Sierra-Lobo/Sierra-Lobo-KiCad-libs/3dmodels/T1M-05-GF-DH.step

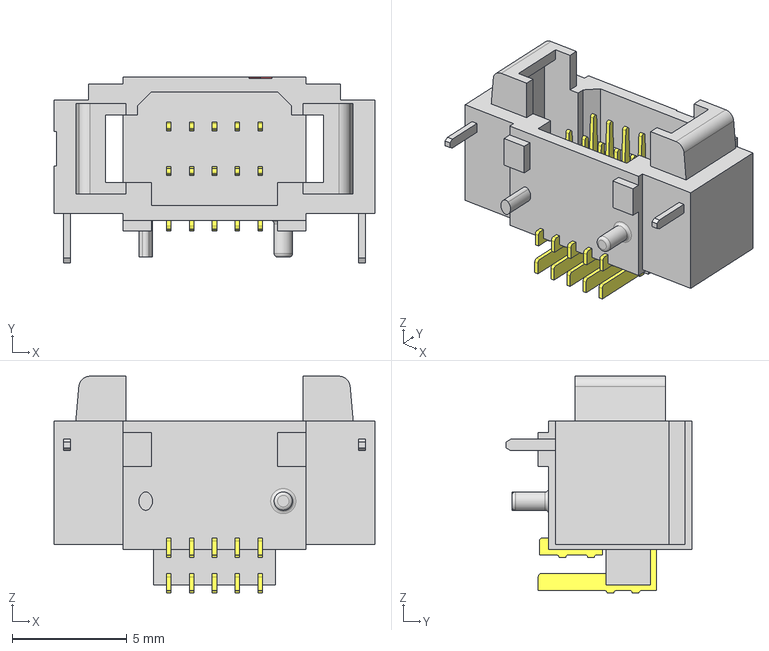
[picture p1: CAD file, 2023-08-02]
3dmodels/T1M-05-GF-DH.step
14.0 x 8.10 x 9.45 mm
P2T1M-05-T-DH
T1T1M-05-T-DH
