Sierra-Lobo/Sierra-Lobo-KiCad-libs/3dmodels/T1M-02-F-SH-L-K.step

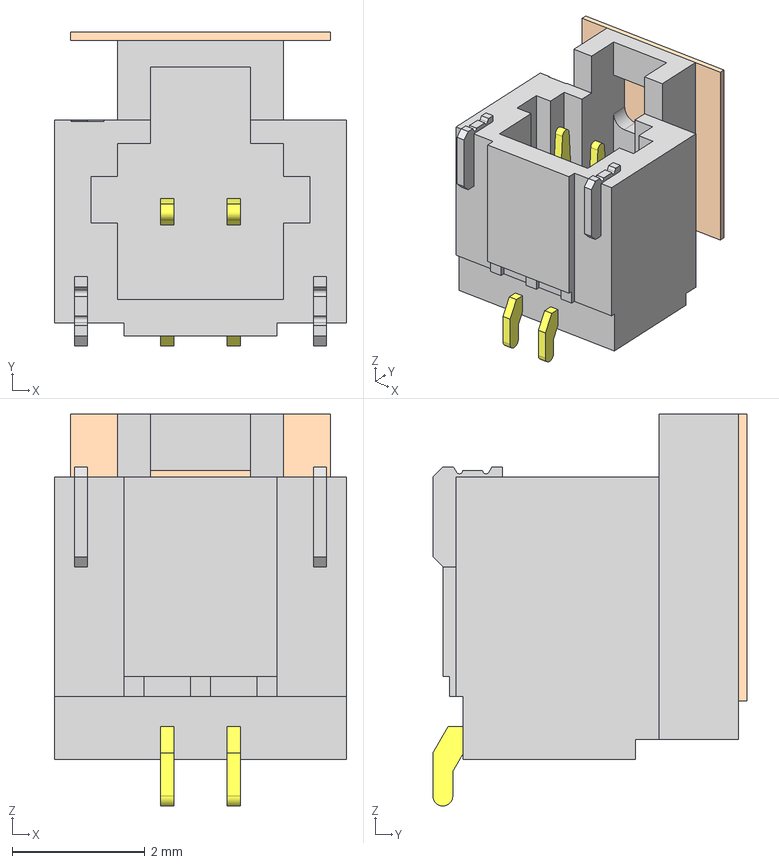
[picture p2: CAD file, 2023-07-25]
3dmodels/T1M-02-F-SH-L-K.step
4.40 x 4.73 x 5.90 mm
K-DOT-154x170-297-005
P2T1M-02-T-SH-L
T1T1M-02-T-SH-L
