Sierra-Lobo/Sierra-Lobo-KiCad-libs/3dmodels/IHLP-2020BZ-01.step

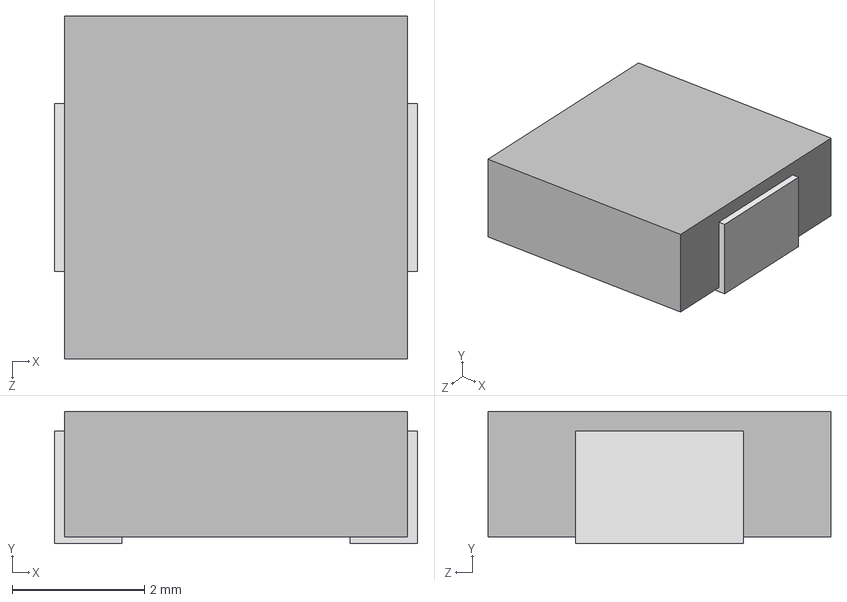
[picture p3: CAD file, 2023-07-25]
3dmodels/IHLP-2020BZ-01.step
5.49 x 2.00 x 5.18 mm
