Sierra-Lobo/Sierra-Lobo-KiCad-libs/3dmodels/T1M-02-F-SH-L.stp

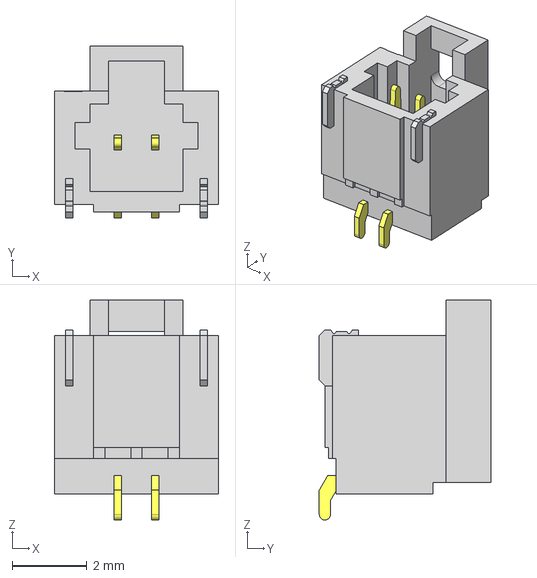
[picture p4: CAD file, 2023-07-25]
3dmodels/T1M-02-F-SH-L.stp
4.40 x 4.60 x 5.90 mm
P2T1M-02-T-SH-L
T1T1M-02-T-SH-L
