Sierra-Lobo/Sierra-Lobo-KiCad-libs/3dmodels/T1M-03-F-SH-L.step

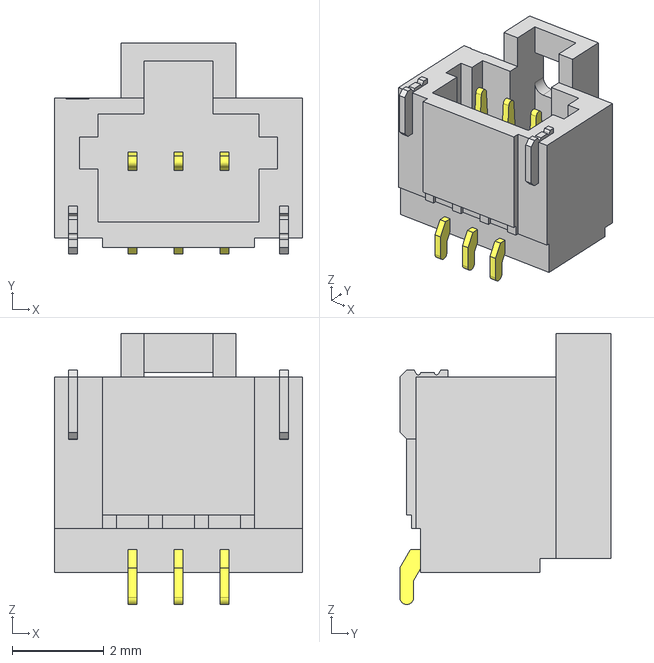
[picture p5: CAD file, 2023-07-25]
3dmodels/T1M-03-F-SH-L.step
5.40 x 4.60 x 5.90 mm
P2T1M-03-T-SH-L
T1T1M-03-T-SH-L
