Sierra-Lobo/Sierra-Lobo-KiCad-libs/3dmodels/T1M-03-F-SV-L.step

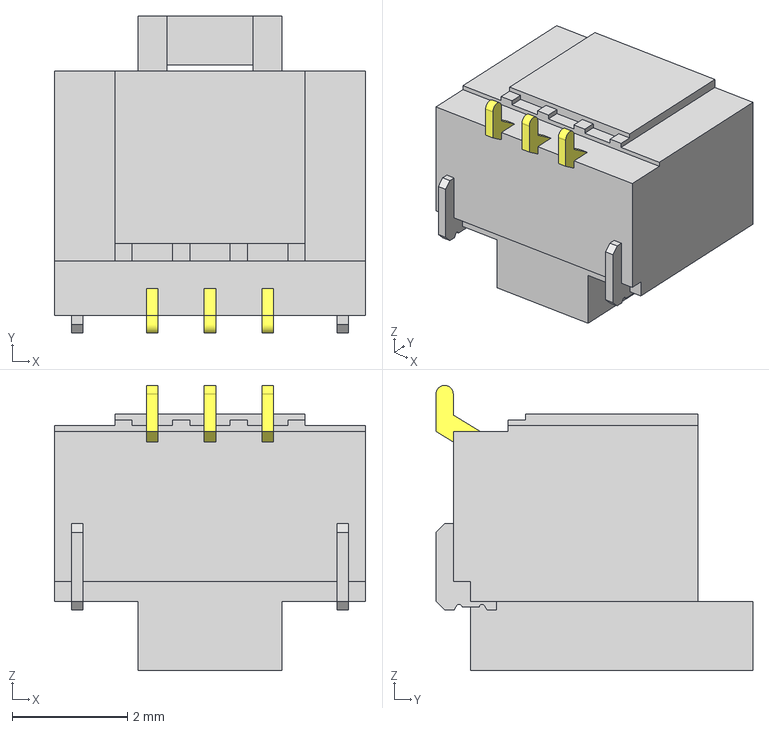
[picture p6: CAD file, 2023-07-25]
3dmodels/T1M-03-F-SV-L.step
5.40 x 5.50 x 4.95 mm
P2T1M-03-T-SV-L
T1T1M-03-T-SV-L
