Sierra-Lobo/Sierra-Lobo-KiCad-libs/3dmodels/imu-stamp_revA.step

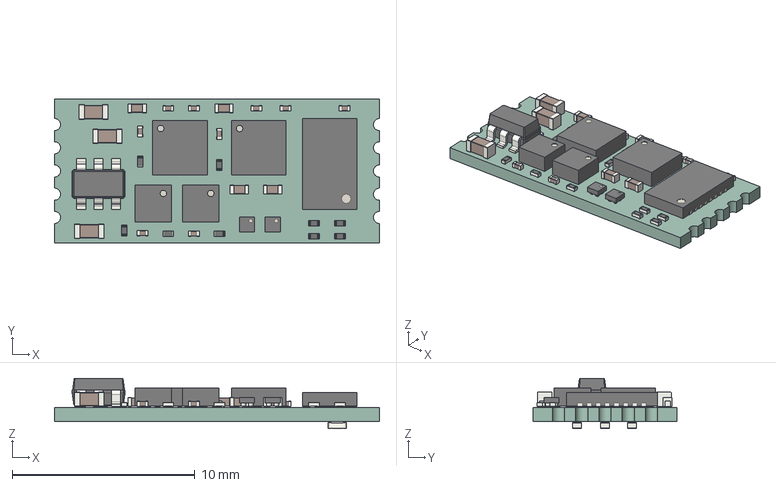
[picture p7: CAD file, 2023-06-14]
3dmodels/imu-stamp_revA.step
17.8 x 7.87 x 2.76 mm
PCB
