Sierra-Lobo/Sierra-Lobo-KiCad-libs/3dmodels/T1M-02-F-SV-L-P.step

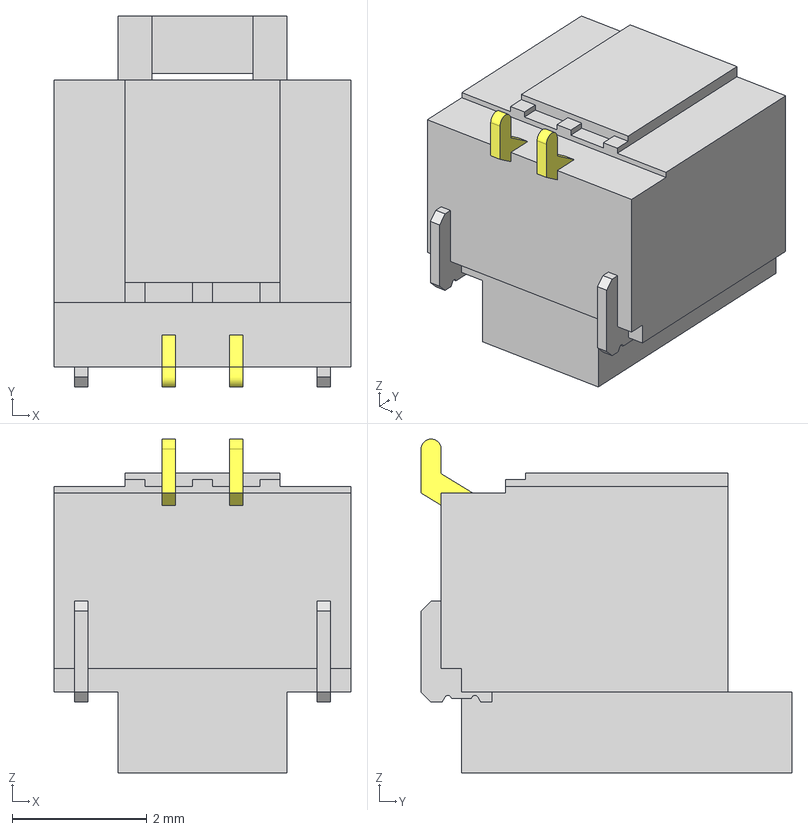
[picture p8: CAD file, 2023-05-31]
3dmodels/T1M-02-F-SV-L-P.step
4.40 x 5.50 x 4.95 mm
P2T1M-02-T-SV-L
T1T1M-02-T-SV-L
