Sierra-Lobo/Sierra-Lobo-KiCad-libs/3dmodels/SSM-102-L-SV-BE-TR.step

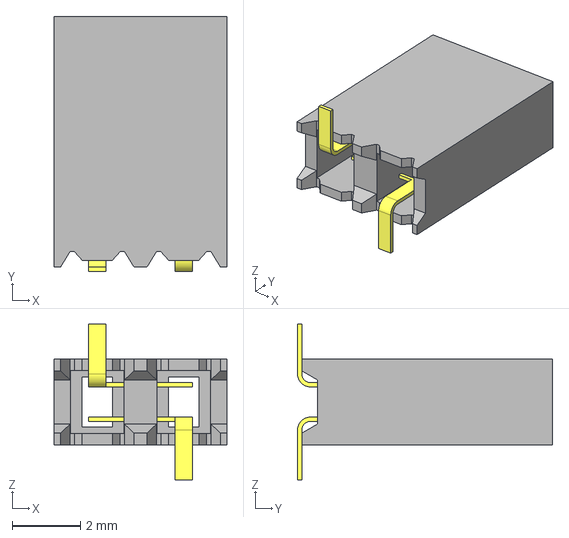
[picture p9: CAD file, 2023-05-31]
3dmodels/SSM-102-L-SV-BE-TR.step
5.08 x 7.49 x 4.57 mm
C-95-022
SSM-102-L-SV-BE-TR_body
