Sierra-Lobo/Sierra-Lobo-KiCad-libs/3dmodels/keystone-PN1056TR.STEP

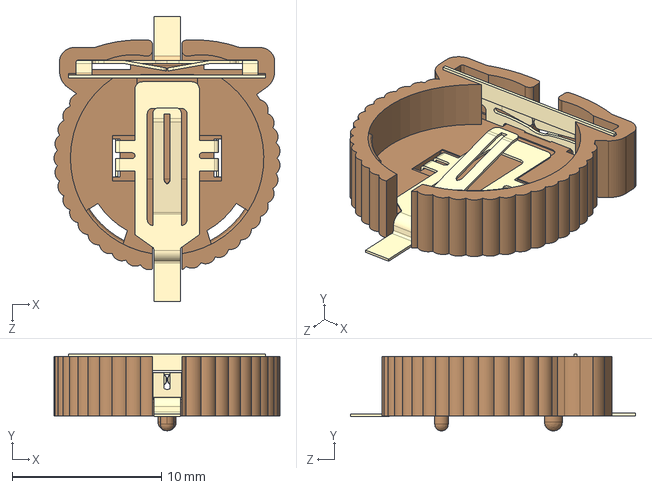
[picture p10: CAD file, 2023-05-31]
3dmodels/keystone-PN1056TR.STEP
15.1 x 5.16 x 19.1 mm
