Sierra-Lobo/Sierra-Lobo-KiCad-libs/3dmodels/KMR231NGLFS.STEP

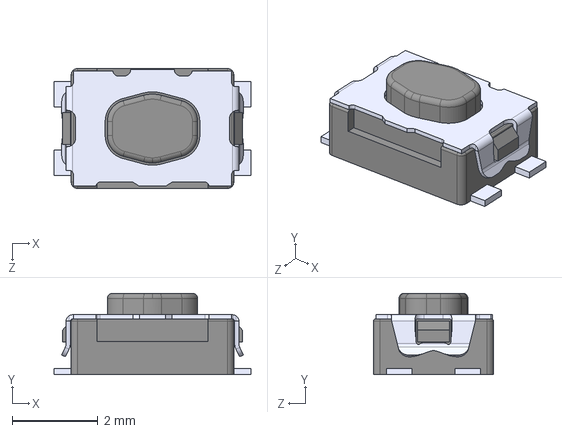
[picture p11: CAD file, 2023-05-19]
3dmodels/KMR231NGLFS.STEP
4.60 x 1.90 x 2.80 mm
