Sierra-Lobo/Sierra-Lobo-KiCad-libs/3dmodels/ZX62-AB-5PA.stp

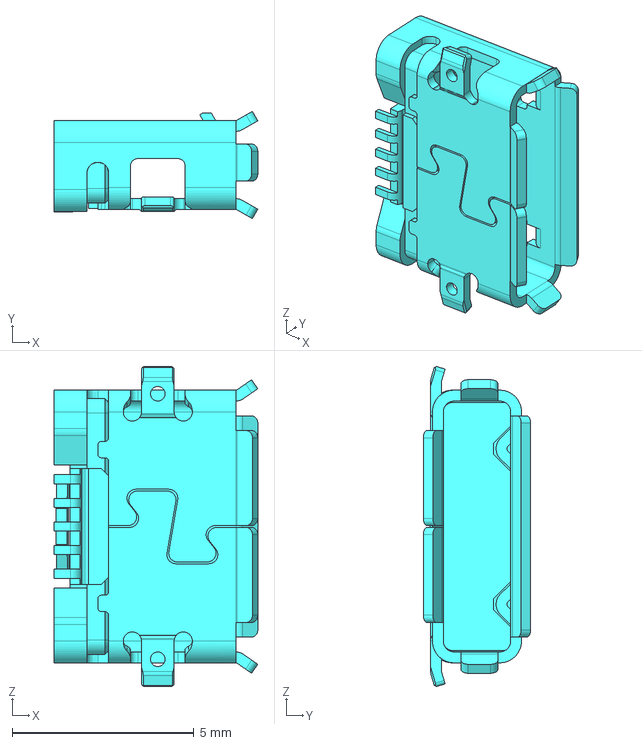
[picture p12: CAD file, 2023-05-19]
3dmodels/ZX62-AB-5PA.stp
5.60 x 2.95 x 8.80 mm
