Sierra-Lobo/Sierra-Lobo-KiCad-libs/3dmodels/INA230AIRGTR.STEP

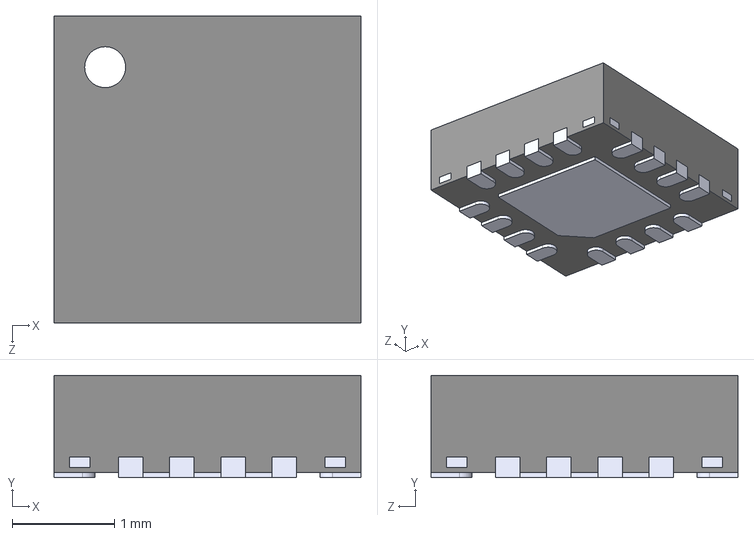
[picture p13: CAD file, 2023-05-19]
3dmodels/INA230AIRGTR.STEP
3.00 x 1.00 x 3.00 mm
