Sierra-Lobo/Sierra-Lobo-KiCad-libs/3dmodels/EVQP7-LC-01P-1.step

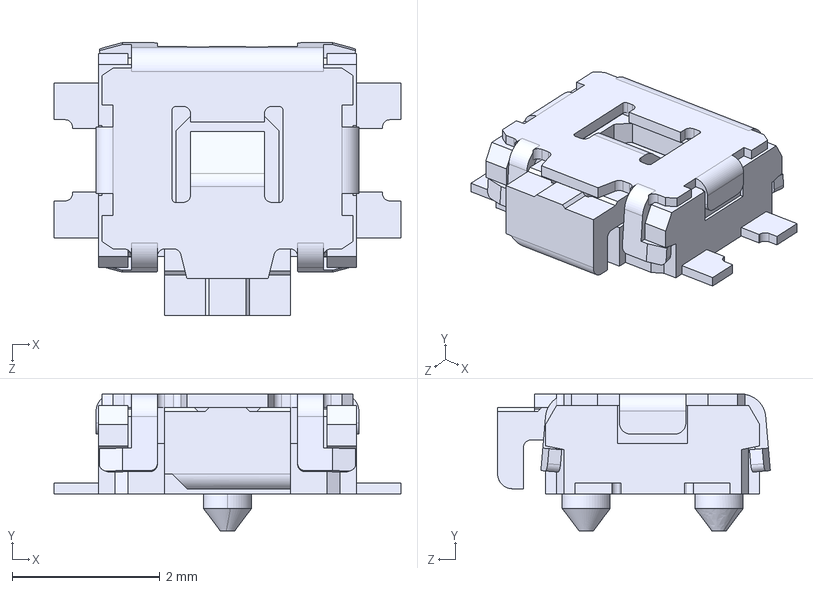
[picture p14: CAD file, 2023-05-19]
3dmodels/EVQP7-LC-01P-1.step
4.70 x 1.85 x 3.69 mm
