Sierra-Lobo/Sierra-Lobo-KiCad-libs/3dmodels/keystone-PN2998TR.STEP

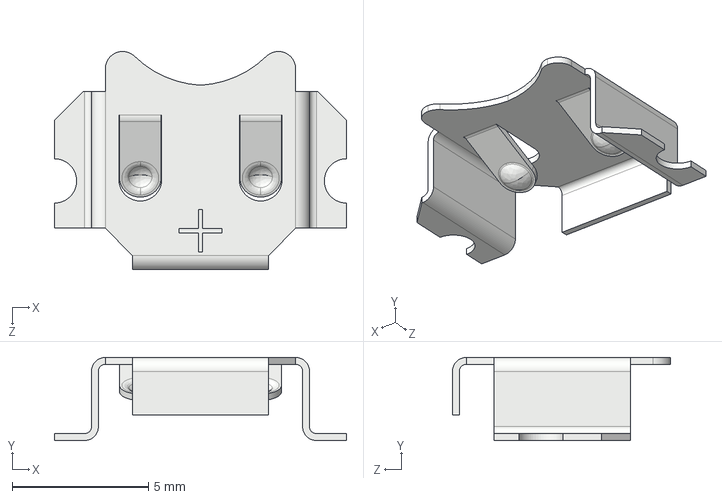
[picture p15: CAD file, 2023-05-19]
3dmodels/keystone-PN2998TR.STEP
10.7 x 3.05 x 8.00 mm
