Sierra-Lobo/Sierra-Lobo-KiCad-libs/3dmodels/sk68xx-ec3210F.stp

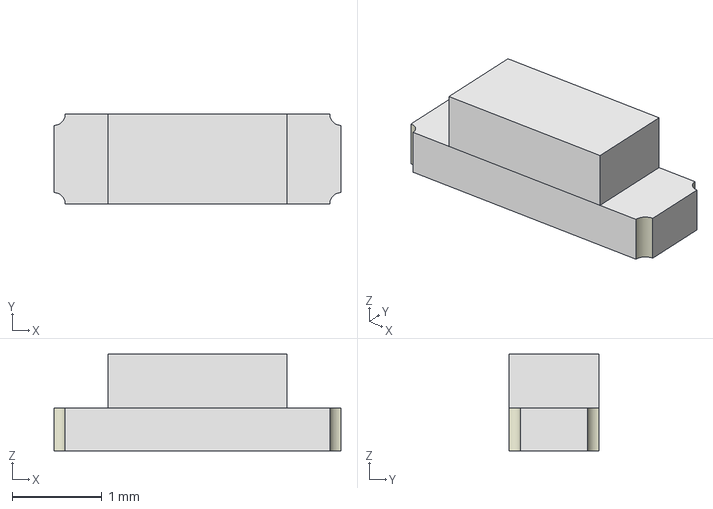
[picture p16: CAD file, 2023-05-19]
3dmodels/sk68xx-ec3210F.stp
3.20 x 1.00 x 1.08 mm
