Sierra-Lobo/Sierra-Lobo-KiCad-libs/3dmodels/SMPM-PS-P-HG-ST-TH-1.step

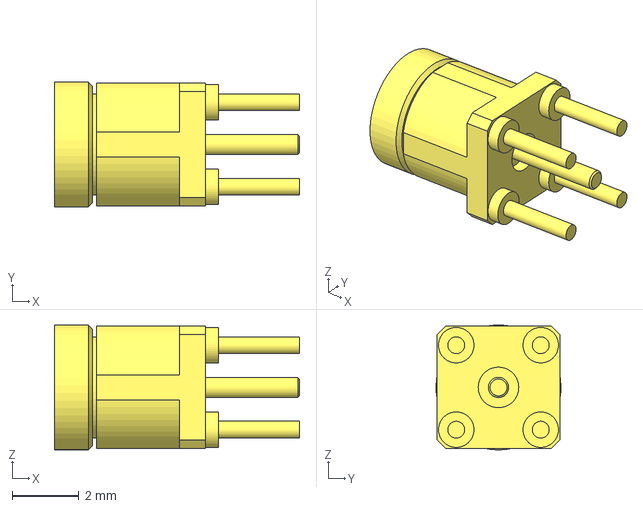
[picture p17: CAD file, 2023-05-19]
3dmodels/SMPM-PS-P-HG-ST-TH-1.step
7.37 x 3.76 x 3.76 mm
