Sierra-Lobo/Sierra-Lobo-KiCad-libs/3dmodels/ABS07-32.768KHZ-T.STEP

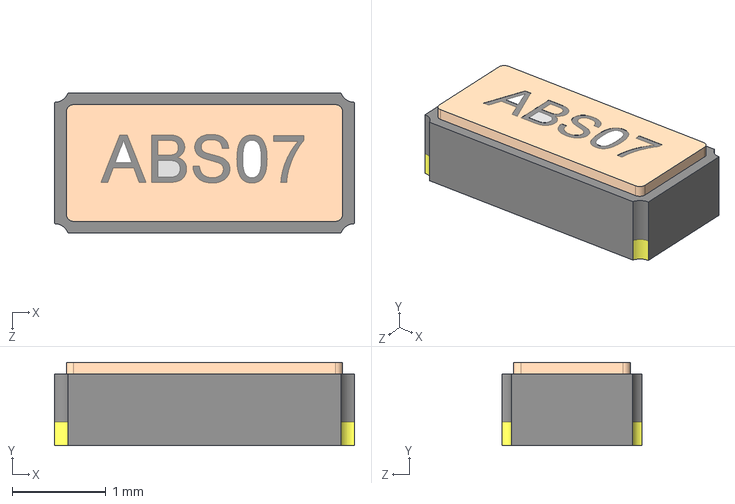
[picture p18: CAD file, 2023-05-19]
3dmodels/ABS07-32.768KHZ-T.STEP
3.20 x 0.889 x 1.50 mm
