Sierra-Lobo/Sierra-Lobo-KiCad-libs/3dmodels/KRL3216T4A.STEP

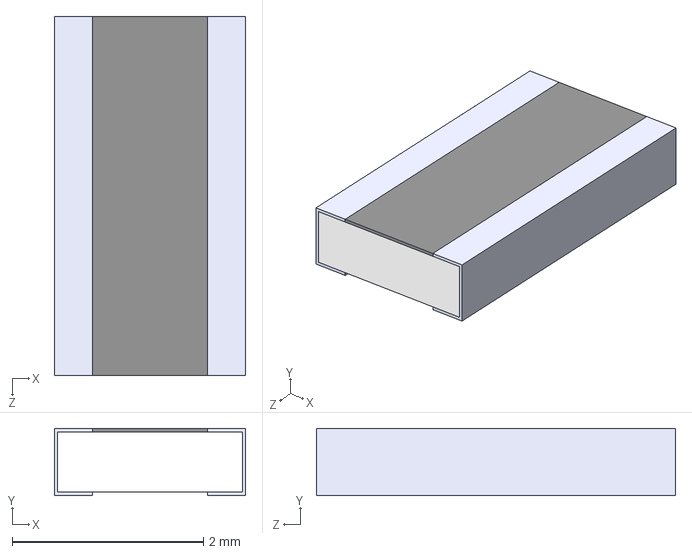
[picture p19: CAD file, 2023-05-19]
3dmodels/KRL3216T4A.STEP
2.00 x 0.7 x 3.75 mm
