Sierra-Lobo/Sierra-Lobo-KiCad-libs/3dmodels/D_SMP.step

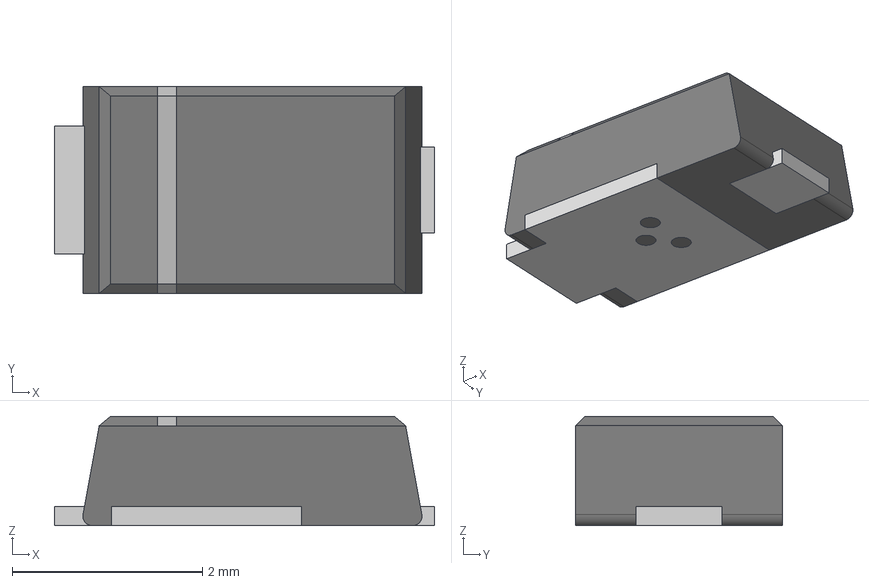
[picture p20: CAD file, 2023-05-19]
3dmodels/D_SMP.step
4.00 x 2.18 x 1.15 mm
Cathode Band
Pads
