Sierra-Lobo/Sierra-Lobo-KiCad-libs/3dmodels/WE-HCI-5040_rev1.stp

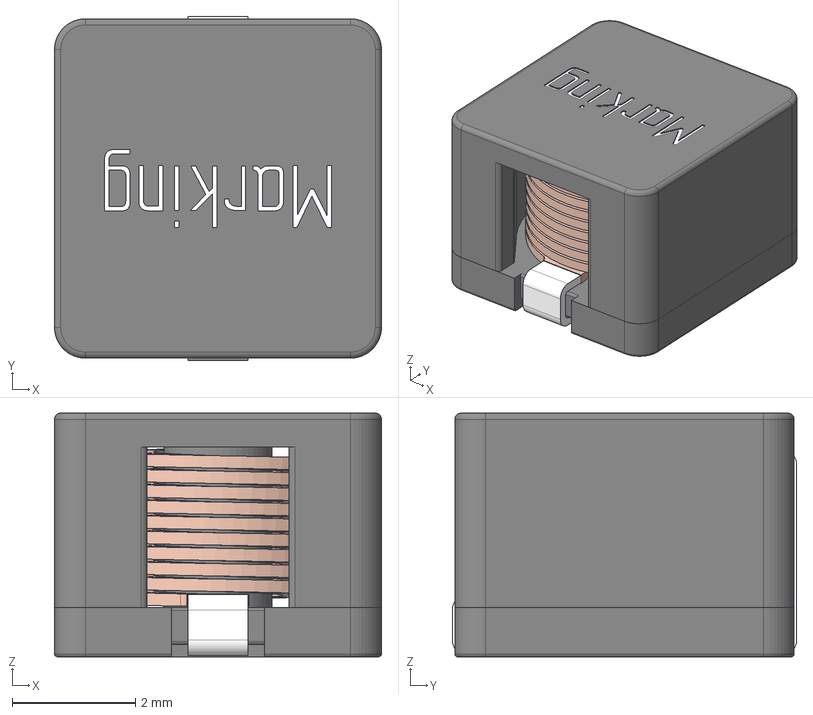
[picture p21: CAD file, 2023-05-19]
3dmodels/WE-HCI-5040_rev1.stp
5.30 x 5.58 x 3.95 mm
Gehäuse
Boden
Spule
