Sierra-Lobo/Sierra-Lobo-KiCad-libs/3dmodels/SOT-723.STEP

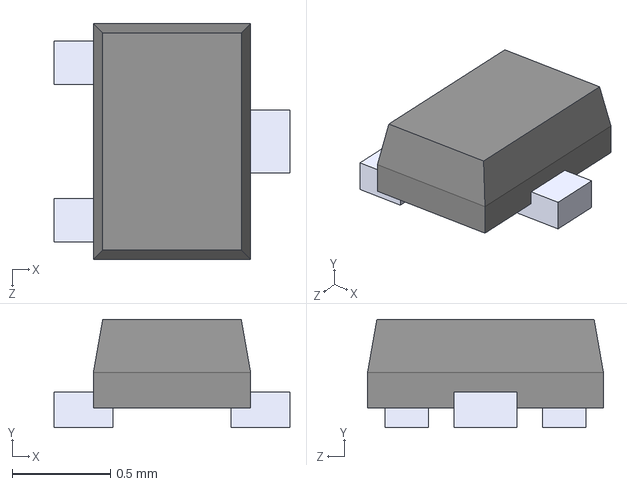
[picture p22: CAD file, 2023-05-19]
3dmodels/SOT-723.STEP
1.20 x 0.55 x 1.20 mm
