Sierra-Lobo/Sierra-Lobo-KiCad-libs/3dmodels/RFM98W.STEP

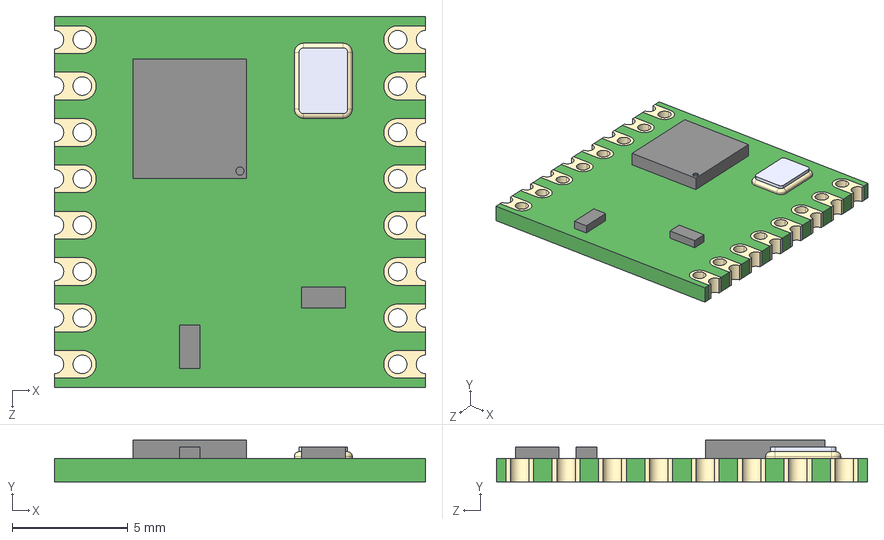
[picture p23: CAD file, 2023-05-19]
3dmodels/RFM98W.STEP
16.0 x 1.80 x 16.0 mm
