Sierra-Lobo/Sierra-Lobo-KiCad-libs/3dmodels/ESD321DPYR.STEP

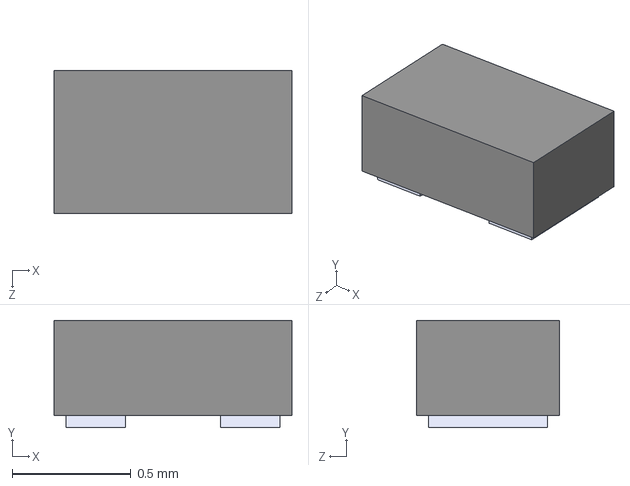
[picture p24: CAD file, 2023-05-19]
3dmodels/ESD321DPYR.STEP
1.00 x 0.45 x 0.6 mm
