Sierra-Lobo/Sierra-Lobo-KiCad-libs/3dmodels/APA2107.STEP

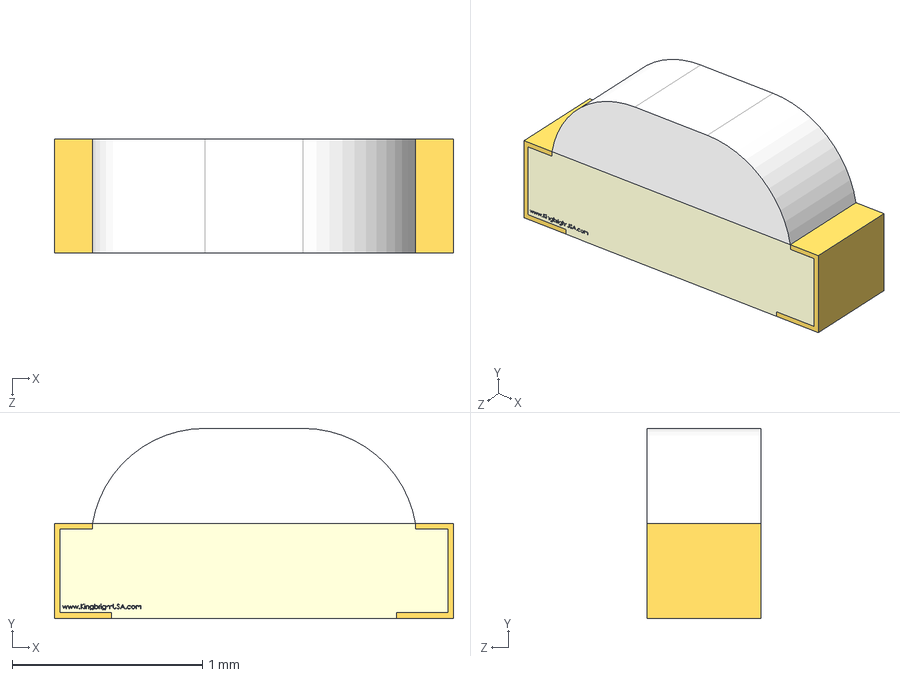
[picture p25: CAD file, 2023-05-19]
3dmodels/APA2107.STEP
2.10 x 1.00 x 0.6 mm
