Sierra-Lobo/Sierra-Lobo-KiCad-libs/3dmodels/MINI-QFN-16L.stp

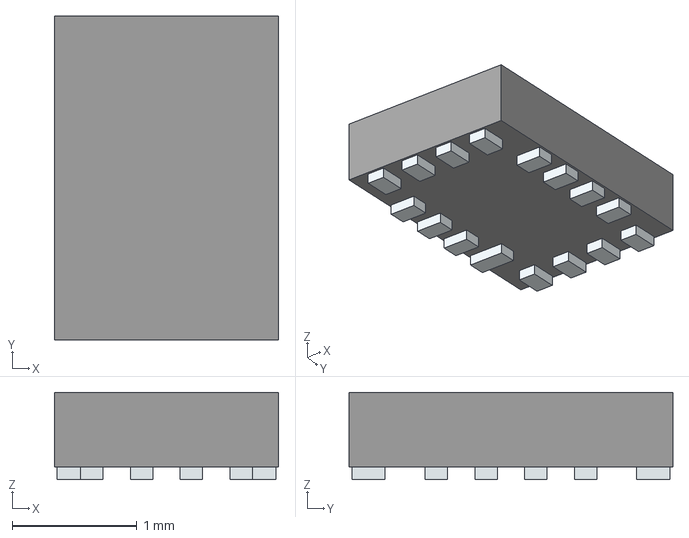
[picture p26: CAD file, 2023-05-19]
3dmodels/MINI-QFN-16L.stp
1.80 x 2.60 x 0.7 mm
Pins
