Sierra-Lobo/Sierra-Lobo-KiCad-libs/3dmodels/WE-LQS-3015_rev1.stp

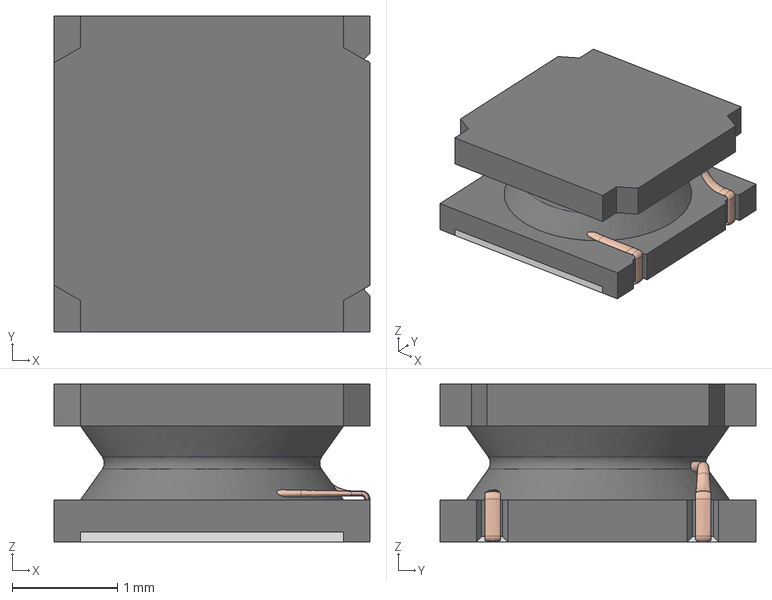
[picture p27: CAD file, 2023-05-19]
3dmodels/WE-LQS-3015_rev1.stp
3.00 x 3.00 x 1.50 mm
