Sierra-Lobo/Sierra-Lobo-KiCad-libs/3dmodels/SFM-130-01-L-D-DS.step

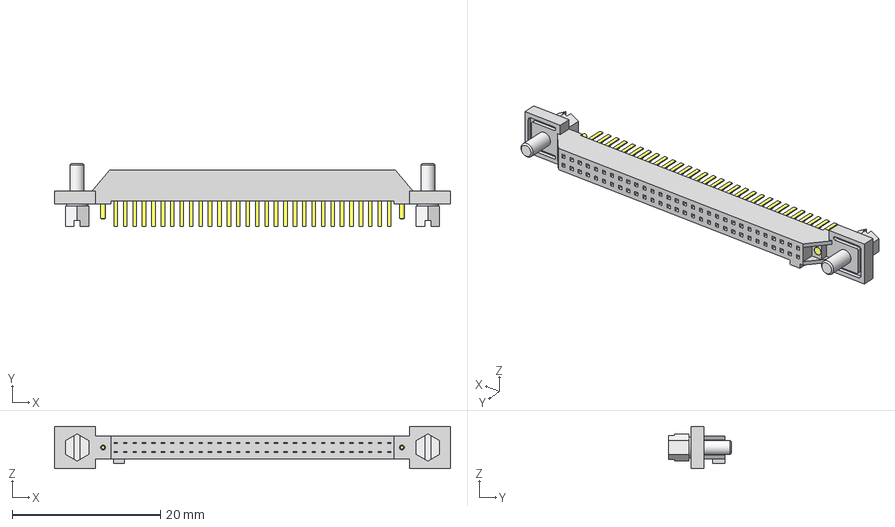
[picture p28: CAD file, 2023-05-12]
3dmodels/SFM-130-01-L-D-DS.step
53.3 x 8.51 x 5.71 mm
WT-27-03-T_-01-D-DS-SN_solder_nail x 2
C-30-01-D_pins
CPS-RR-M2-01_dual_screw x 2
SFM-130-01-L-D-DS_terminal
