Sierra-Lobo/Sierra-Lobo-KiCad-libs/3dmodels/UMPS-04-05.5-G-V-S-TR.stp

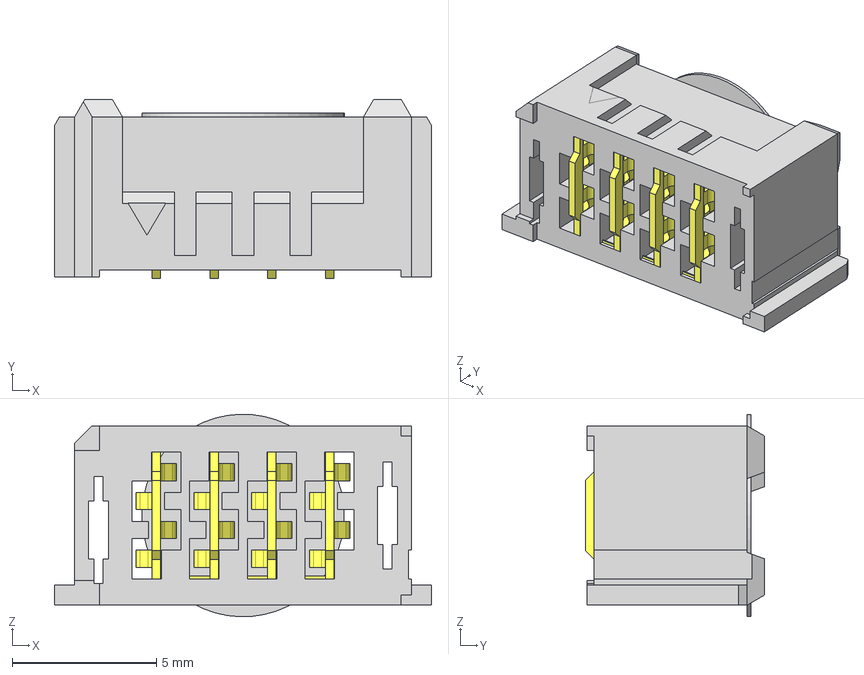
[picture p29: CAD file, 2023-05-12]
3dmodels/UMPS-04-05.5-G-V-S-TR.stp
13.1 x 6.20 x 7.01 mm
K-DOT-0.276-.005_KAPTON
04-05.5-S_PINS2
UMPS-04-05.5-S_PINS
04-05.5--_BODY
