Sierra-Lobo/Sierra-Lobo-KiCad-libs/3dmodels/CKG57NX7S1C107M500JJ.step

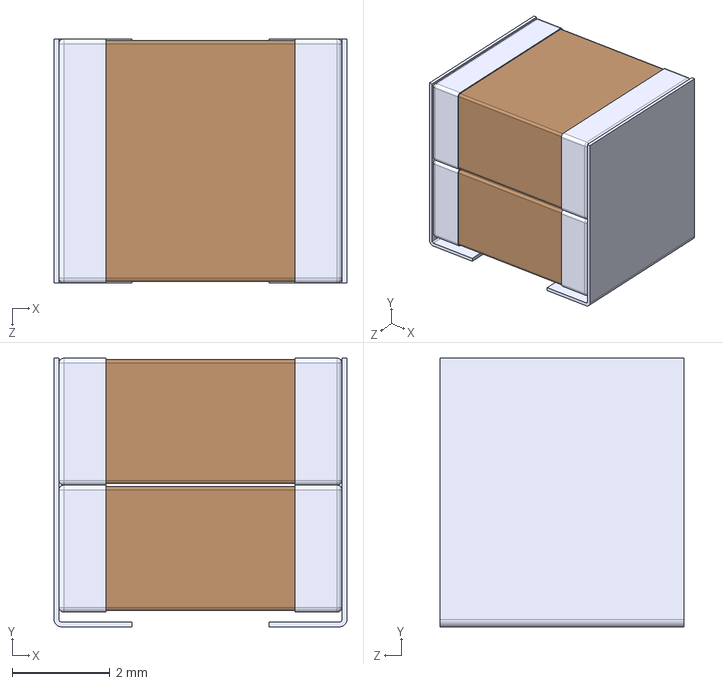
[picture p30: CAD file, 2023-05-07]
3dmodels/CKG57NX7S1C107M500JJ.step
6.00 x 5.50 x 5.00 mm
