Sierra-Lobo/Sierra-Lobo-KiCad-libs/3dmodels/RAVF164D.stp

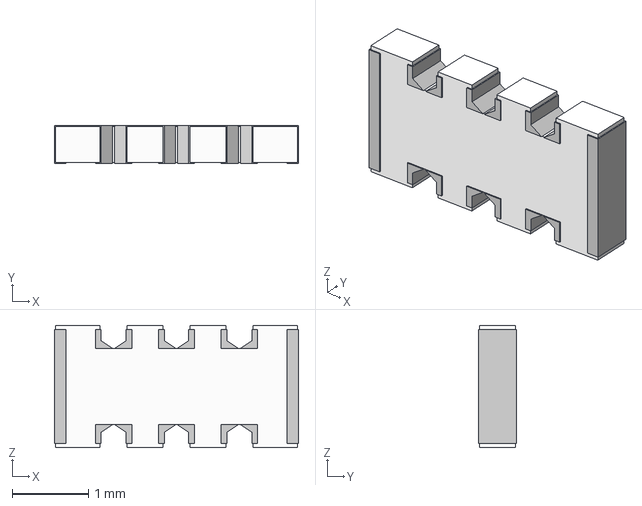
[picture p31: CAD file, 2023-04-01]
3dmodels/RAVF164D.stp
3.20 x 0.5 x 1.60 mm
