Sierra-Lobo/Sierra-Lobo-KiCad-libs/3dmodels/RockBLOCK_V_3B.STEP

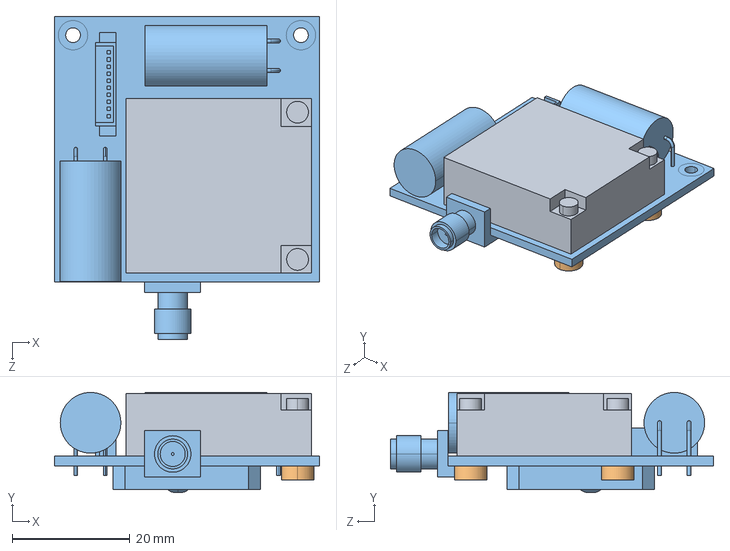
[picture p32: CAD file, 2023-04-01]
3dmodels/RockBLOCK_V_3B.STEP
45.0 x 17.0 x 54.9 mm
