Sierra-Lobo/Sierra-Lobo-KiCad-libs/3dmodels/WE-PD_1210.stp

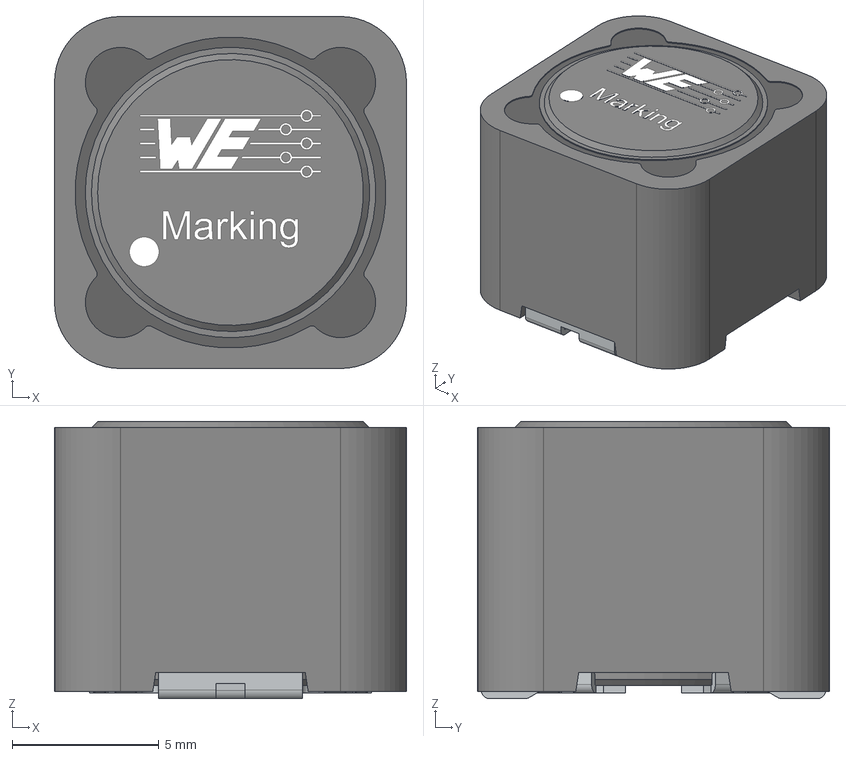
[picture p33: CAD file, 2023-04-01]
3dmodels/WE-PD_1210.stp
12.0 x 12.0 x 9.46 mm
Core
ShieldRing
Glue
Leadframe
