Sierra-Lobo/Sierra-Lobo-KiCad-libs/3dmodels/CLP-130-02-X-D-BE-A-P-TR.step

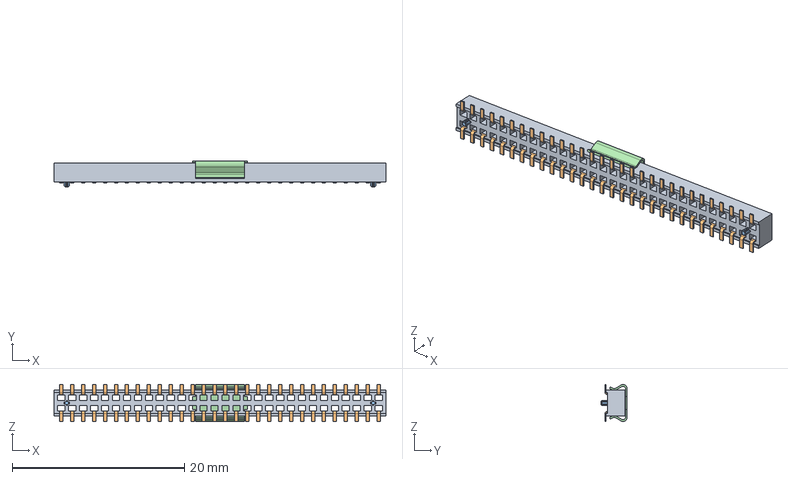
[picture p34: CAD file, 2023-04-01]
3dmodels/CLP-130-02-X-D-BE-A-P-TR.step
38.5 x 3.02 x 4.32 mm
_CLP-130-2-F-D-BE-A-P_terminal
_C-106-22-130-BE_Pin x 2
_CLP_ap x 2
_LMP-01-CLP30_mp
