Sierra-Lobo/Sierra-Lobo-KiCad-libs/3dmodels/T2M-105-01-X-D-TH-DS.step

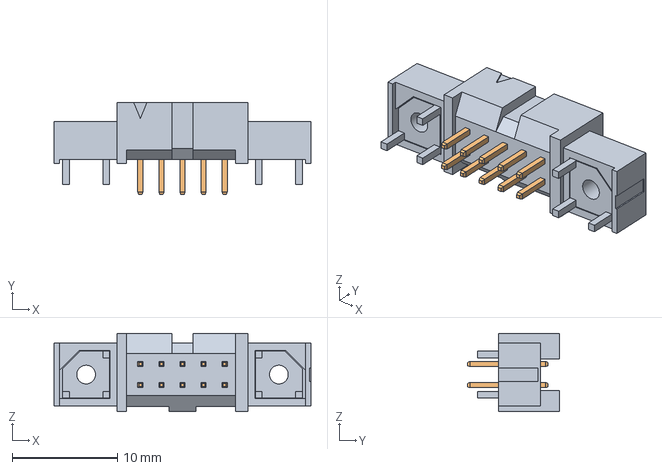
[picture p35: CAD file, 2023-04-01]
3dmodels/T2M-105-01-X-D-TH-DS.step
24.4 x 8.76 x 7.44 mm
_B1T2M-05-D-TH-DS
_P2T2M-05-D-TH-DS
