Sierra-Lobo/Sierra-Lobo-KiCad-libs/3dmodels/R107.064.070C.stp

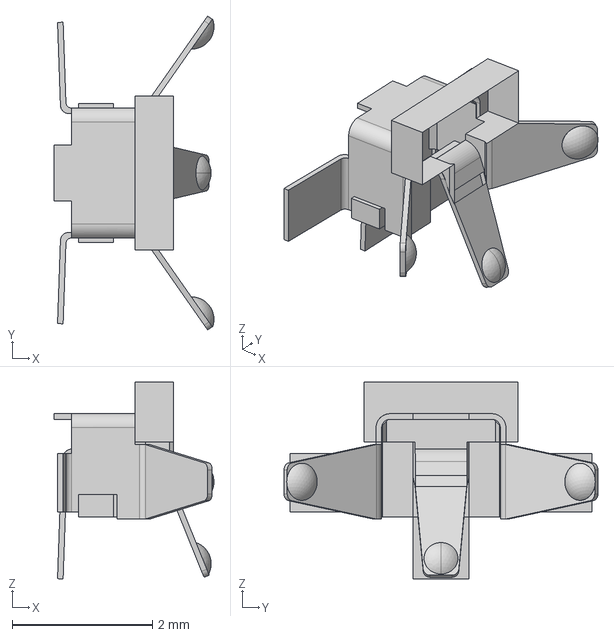
[picture p36: CAD file, 2023-04-01]
3dmodels/R107.064.070C.stp
2.28 x 4.47 x 2.80 mm
