Sierra-Lobo/Sierra-Lobo-KiCad-libs/3dmodels/T1M-06-F-SV-L.step

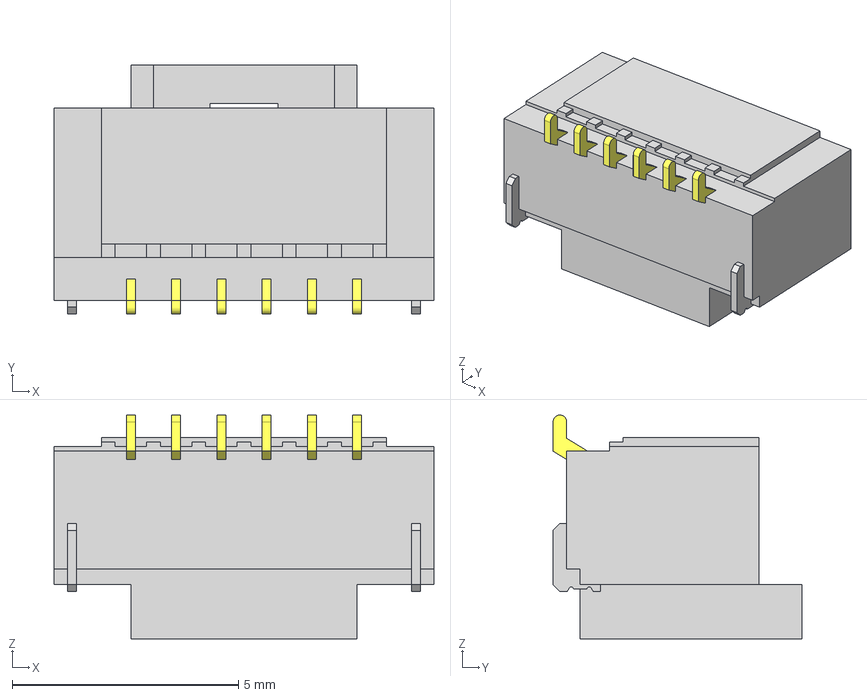
[picture p37: CAD file, 2023-04-01]
3dmodels/T1M-06-F-SV-L.step
8.40 x 5.50 x 4.95 mm
_T1T1M-06-T-SV-L
_P2T1M-06-T-SV-L
