Sierra-Lobo/Sierra-Lobo-KiCad-libs/3dmodels/SMPM-PS-P-HG-ST-EM-1.stp

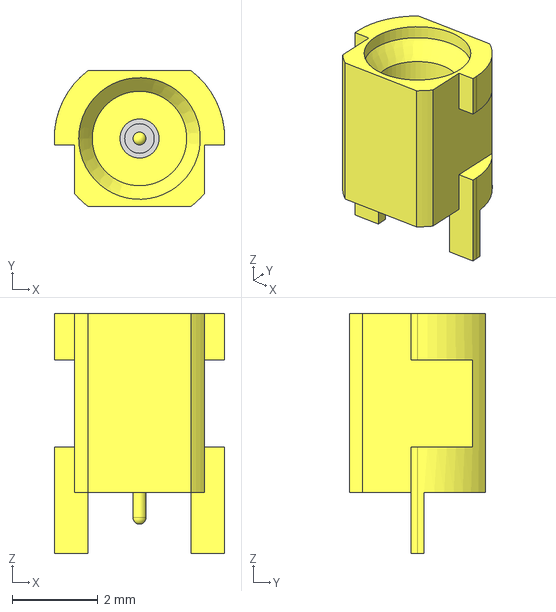
[picture p39: CAD file, 2023-04-01]
3dmodels/SMPM-PS-P-HG-ST-EM-1.stp
3.99 x 3.17 x 5.61 mm
