Sierra-Lobo/Sierra-Lobo-KiCad-libs/3dmodels/SSM-130-L-DV.step

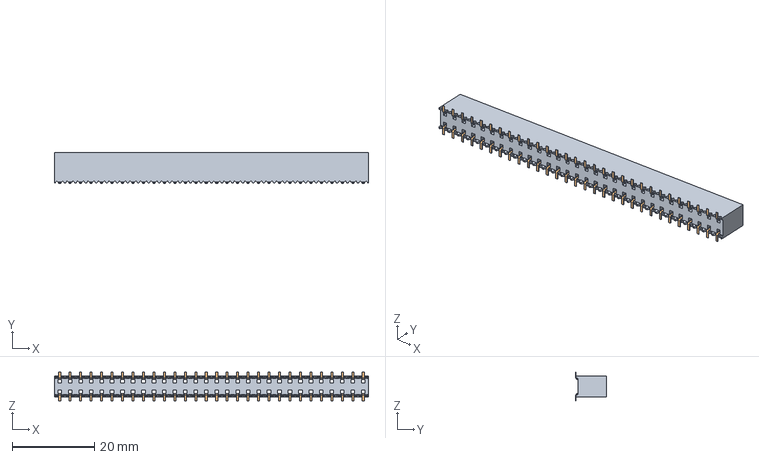
[picture p41: CAD file, 2023-04-01]
3dmodels/SSM-130-L-DV.step
76.2 x 7.42 x 7.04 mm
_SSM-130-L-DV_body
_C-137-0130
