Sierra-Lobo/Sierra-Lobo-KiCad-libs/3dmodels/SRN8040TA-6R8M.STEP

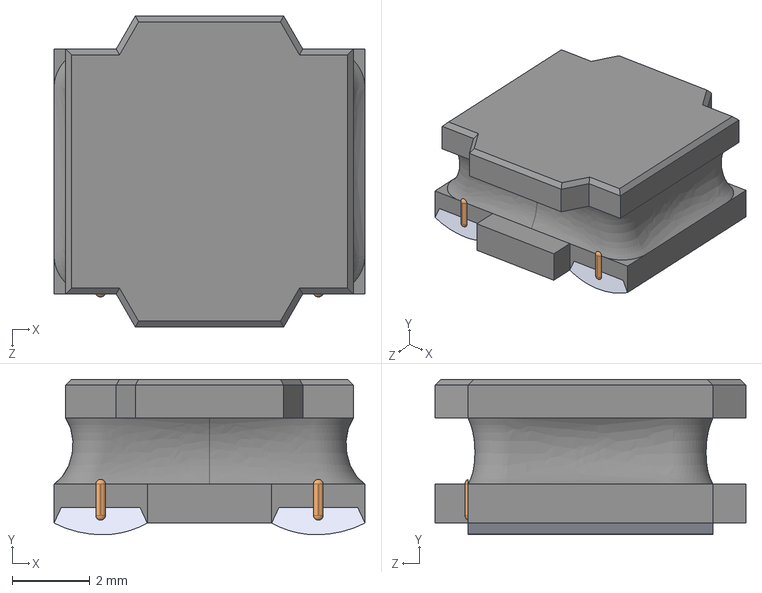
[picture p42: CAD file, 2023-04-01]
3dmodels/SRN8040TA-6R8M.STEP
8.00 x 4.00 x 8.00 mm
