Sierra-Lobo/Sierra-Lobo-KiCad-libs/3dmodels/T1M-15-X-DV.step

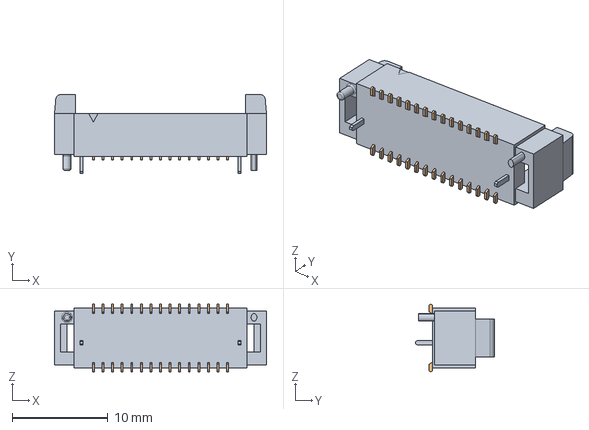
[picture p43: CAD file, 2023-04-01]
3dmodels/T1M-15-X-DV.step
22.1 x 8.20 x 7.05 mm
_T1T1M-15-T-DV
_P2T1M-15-T-DV
