Sierra-Lobo/Sierra-Lobo-KiCad-libs/3dmodels/DF13-4P-1.25DSA.stp

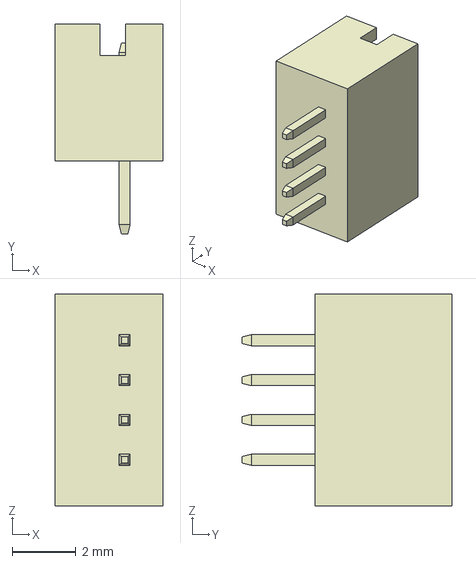
[picture p46: CAD file, 2023-04-01]
3dmodels/DF13-4P-1.25DSA.stp
3.40 x 6.60 x 6.65 mm
