Sierra-Lobo/Sierra-Lobo-KiCad-libs/3dmodels/ADM1176-1ARMZ-R7.STEP

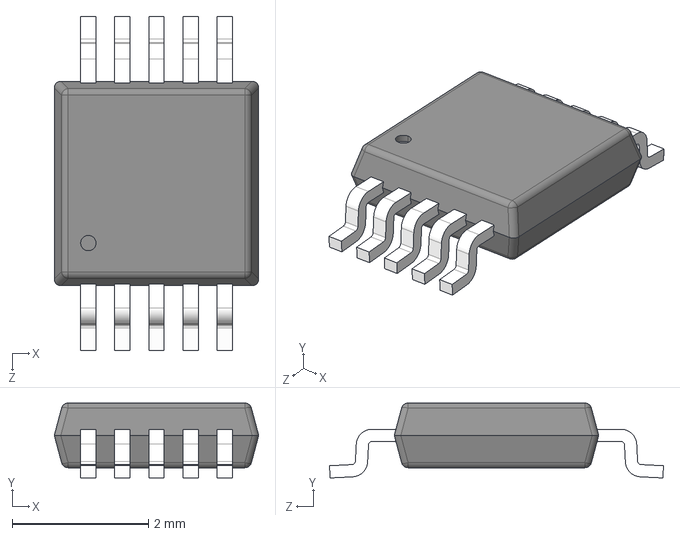
[picture p47: CAD file, 2023-04-01]
3dmodels/ADM1176-1ARMZ-R7.STEP
3.00 x 1.10 x 4.90 mm
