Sierra-Lobo/Sierra-Lobo-KiCad-libs/3dmodels/LED_Ring.step

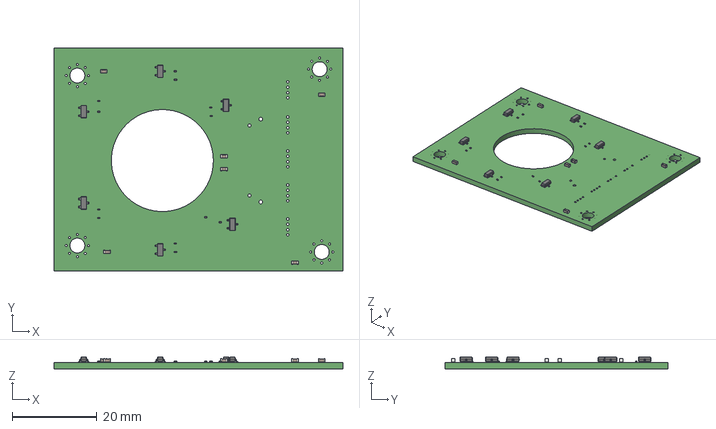
[picture p48: CAD file, 2023-04-01]
3dmodels/LED_Ring.step
68.0 x 52.5 x 2.85 mm
