Sierra-Lobo/Sierra-Lobo-KiCad-libs/3dmodels/FTSH-130-04-L-DH.step

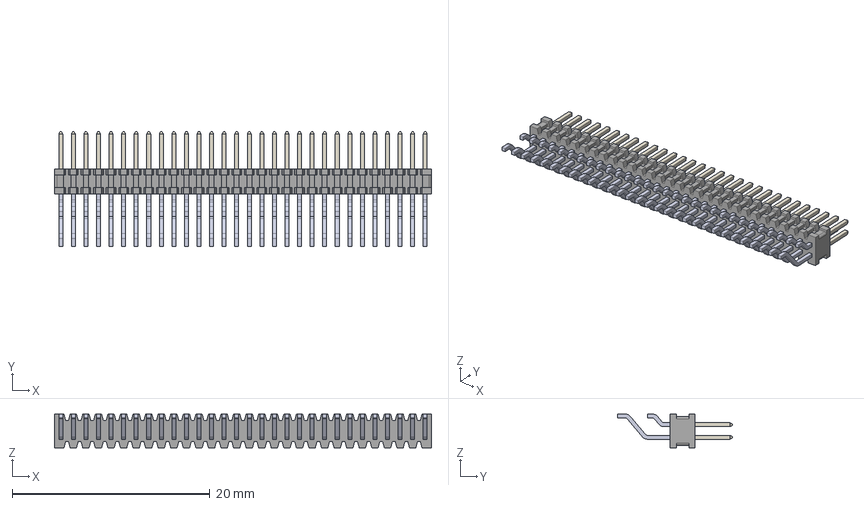
[picture p49: CAD file, 2023-04-01]
3dmodels/FTSH-130-04-L-DH.step
38.1 x 11.7 x 3.43 mm
