Sierra-Lobo/Sierra-Lobo-KiCad-libs/3dmodels/WE-PD_1260.stp

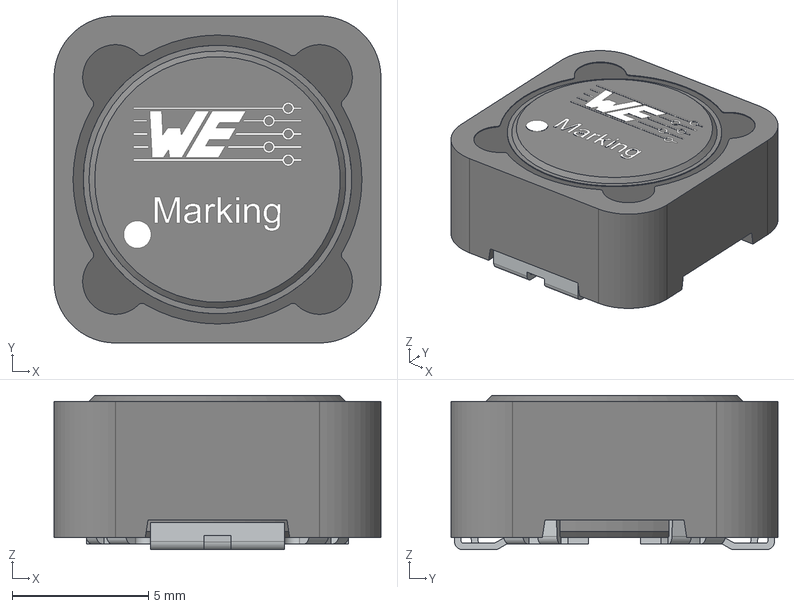
[picture p50: CAD file, 2023-04-01]
3dmodels/WE-PD_1260.stp
12.0 x 12.0 x 5.66 mm
Core
ShieldRing
Glue
Leadframe
