Sierra-Lobo/Sierra-Lobo-KiCad-libs/3dmodels/LM301H.stp

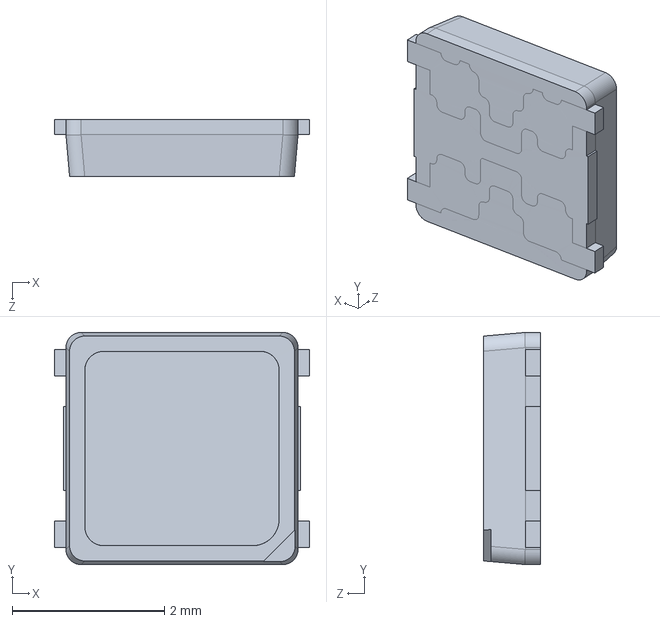
[picture p51: CAD file, 2023-04-01]
3dmodels/LM301H.stp
3.35 x 3.05 x 0.751 mm
