Sierra-Lobo/Sierra-Lobo-KiCad-libs/3dmodels/DF13-10P-1.25DSA.stp

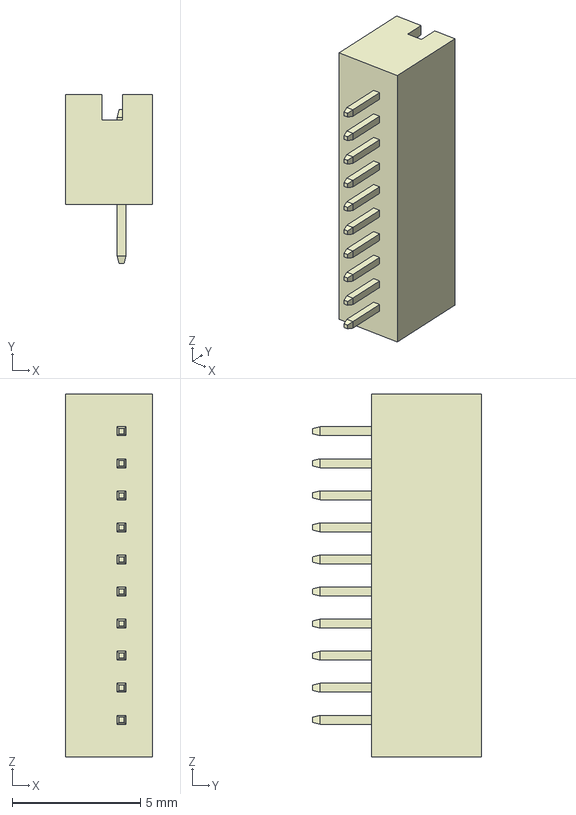
[picture p52: CAD file, 2023-04-01]
3dmodels/DF13-10P-1.25DSA.stp
3.40 x 6.60 x 14.1 mm
