Sierra-Lobo/Sierra-Lobo-KiCad-libs/3dmodels/6021-0-15-15-16-XX-10-0.step

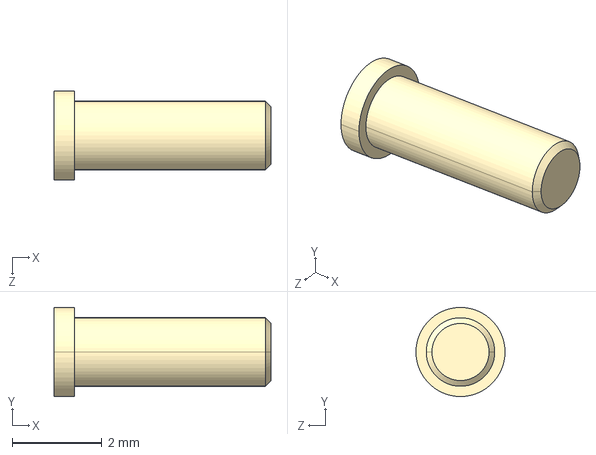
[picture p53: CAD file, 2023-04-01]
3dmodels/6021-0-15-15-16-XX-10-0.step
4.83 x 1.98 x 1.98 mm
