Sierra-Lobo/Sierra-Lobo-KiCad-libs/3dmodels/2-1437565-9.step

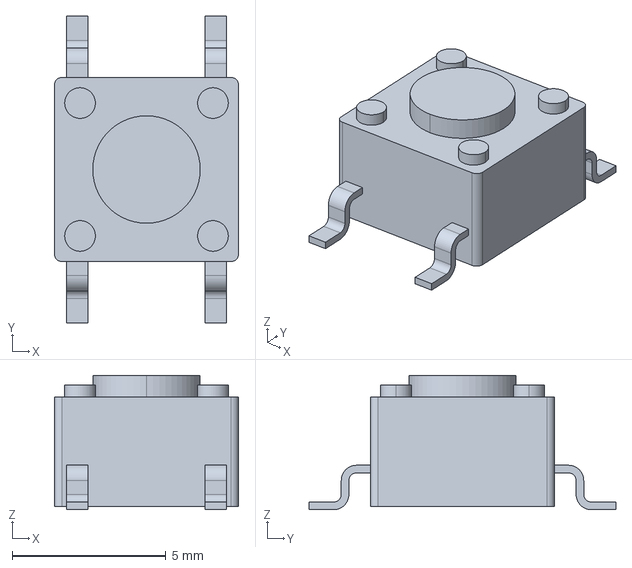
[picture p54: CAD file, 2023-04-01]
3dmodels/2-1437565-9.step
6.00 x 10.0 x 4.38 mm
