Sierra-Lobo/Sierra-Lobo-KiCad-libs/3dmodels/B3B-ZR.STEP

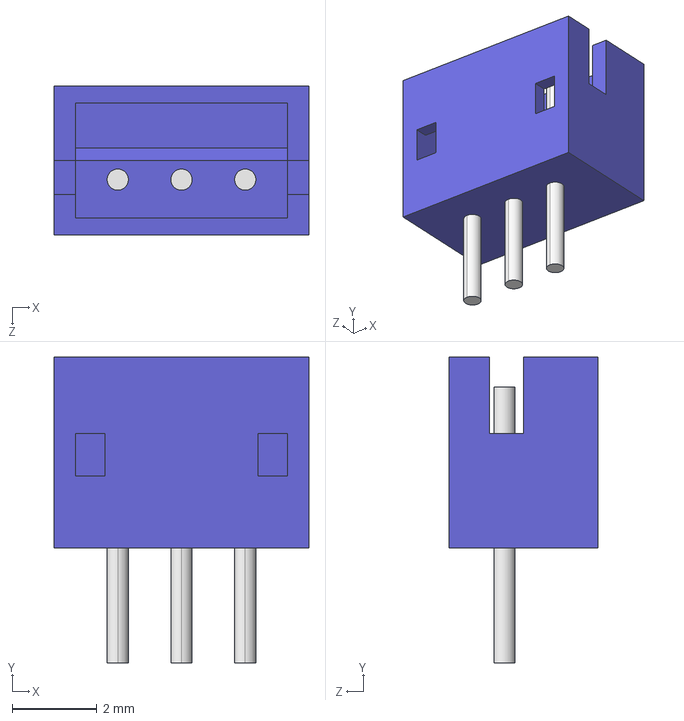
[picture p55: CAD file, 2023-04-01]
3dmodels/B3B-ZR.STEP
6.00 x 7.20 x 3.50 mm
