Sierra-Lobo/Sierra-Lobo-KiCad-libs/3dmodels/T1M-08-F-SV-L.step

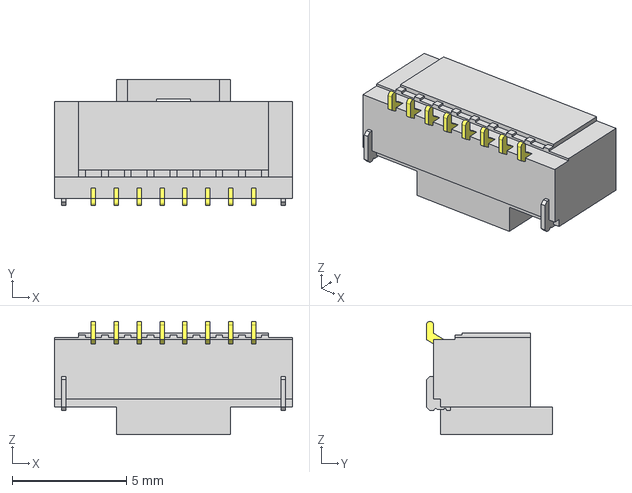
[picture p57: CAD file, 2023-03-30]
3dmodels/T1M-08-F-SV-L.step
10.4 x 5.50 x 4.95 mm
_T1T1M-08-T-SV-L
_P2T1M-08-T-SV-L
