Sierra-Lobo/Sierra-Lobo-KiCad-libs/(list of files, cad)

Other CAD files:
3dmodels/1625854-3.step
3dmodels/5031821852--3DModel-STEP-56544.STEP
3dmodels/733000030.stp
3dmodels/OS102011MS2QN1.step
3dmodels/PE014006.stp
3dmodels/RockBLOCK_V_3B.stp
3dmodels/T1M-03-F-SV-L.stp
3dmodels/T1M-04-F-SV-L.stp
3dmodels/TPS54226PWPR.STEP
3dmodels/TPS630701RNMR.STEP
