Sierra-Lobo/Sierra-Lobo-KiCad-libs/(commit log)

2023-04-01 moved most project footprints here.
    [2-1437565-9.step, 6021-0-15-15-16-XX-10-0.step, 733000030.stp, ADM1176-1ARMZ-R7.STEP, B3B-ZR.STEP, CLP-130-02-X-D-BE-A-P-TR.step, DF13-10P-1.25DSA.stp, DF13-4P-1.25DSA.stp]
2023-05-19 added 3d models for mainboard parts
    [5031821852--3DModel-STEP-56544.STEP, ABS07-32.768KHZ-T.STEP, APA2107.STEP, D_SMP.step, ESD321DPYR.STEP, EVQP7-LC-01P-1.step, INA230AIRGTR.STEP, KMR231NGLFS.STEP]
2023-05-31 added 3d models
    [SSM-102-L-SV-BE-TR.step, T1M-02-F-SV-L-P.step, keystone-PN1056TR.STEP]
2023-06-16 test points, B size drawing sheet
    [1625854-3.step]
2023-07-26 made graphics not show up in bom/be removed
2023-08-02 added t1m-05-gf-dh
    [T1M-05-GF-DH.step]
