Sierra-Lobo/Sierra-Lobo-KiCad-libs/(notices)

Notices in the files:
3dmodels/T1M-02-F-SV-L-P.step:
author */ ('License CC BY-ND 4.0'),
3dmodels/CLP-130-02-X-D-BE-A-P-TR.step:
FILE_NAME( 'e:/temp/worker_5/temp/exporttempdir_6280_965_QoHH6/format_0/CLP-130-02-F-D-BE-A-P.stp', '2021-12-20T14:17:39', ( 'License CC BY-ND 4.0' ), ( 'CADENAS' ), ' ', 'PARTsolutions', ' ' );
3dmodels/T2M-105-01-X-D-TH-DS.step:
FILE_NAME( 'e:/temp/worker_139/temp/exporttempdir_3312_281_kxKBl/format_0/T2M-105-01-L-D-TH-DS.stp', '2021-11-30T00:03:10', ( 'License CC BY-ND 4.0' ), ( 'CADENAS' ), ' ', 'PARTsolutions', ' ' );
3dmodels/T1M-08-F-SV-L.step:
FILE_NAME( 'e:/temp/worker_83/temp/exporttempdir_6520_257_S5wpK/format_0/T1M-08-F-SV-L.stp', '2022-05-23T23:01:58', ( 'License CC BY-ND 4.0' ), ( 'CADENAS' ), ' ', 'PARTsolutions', ' ' );
3dmodels/T1M-02-X-DV.step:
FILE_NAME( 'e:/temp/worker_307/temp/exporttempdir_4324_31_iCjb0/format_0/T1M-02-GF-DV.stp', '2022-05-09T16:57:27', ( 'License CC BY-ND 4.0' ), ( 'CADENAS' ), ' ', 'PARTsolutions', ' ' );
3dmodels/T1M-10-F-SV-L.step:
FILE_NAME( 'e:/temp/worker_35/temp/exporttempdir_6704_527_t6kp7/format_0/T1M-10-F-SV-L.stp', '2022-05-11T19:27:32', ( 'License CC BY-ND 4.0' ), ( 'CADENAS' ), ' ', 'PARTsolutions', ' ' );
3dmodels/T1M-06-F-SV-L.step:
FILE_NAME( 'e:/temp/worker_309/temp/exporttempdir_836_421_uEede/format_0/T1M-06-F-SV-L.stp', '2022-05-09T17:54:31', ( 'License CC BY-ND 4.0' ), ( 'CADENAS' ), ' ', 'PARTsolutions', ' ' );
3dmodels/T1M-05-X-DV.step:
FILE_NAME( 'e:/temp/worker_33/temp/exporttempdir_1068_1339_HvqPd/format_0/T1M-05-GF-DV.stp', '2022-01-14T00:29:01', ( 'License CC BY-ND 4.0' ), ( 'CADENAS' ), ' ', 'PARTsolutions', ' ' );
3dmodels/T1M-15-GF-DV.stp:
FILE_NAME( 'e:/temp/worker_97/temp/exporttempdir_5504_1104_X9lIq/format_0/T1M-15-GF-DV.stp', '2021-10-18T23:59:50', ( 'License CC BY-ND 4.0' ), ( 'CADENAS' ), ' ', 'PARTsolutions', ' ' );
3dmodels/T1M-03-X-DV.step:
FILE_NAME( 'e:/temp/worker_305/temp/exporttempdir_8128_58_O1G4T/format_0/T1M-03-GF-DV.stp', '2022-05-09T16:54:09', ( 'License CC BY-ND 4.0' ), ( 'CADENAS' ), ' ', 'PARTsolutions', ' ' );
3dmodels/SSM-130-L-DV.step:
FILE_NAME( 'e:/temp/worker_106/temp/exporttempdir_3656_310_0xERr/format_0/SSM-130-L-DV.stp', '2021-12-22T17:56:09', ( 'License CC BY-ND 4.0' ), ( 'CADENAS' ), ' ', 'PARTsolutions', ' ' );
3dmodels/T1M-04-F-SV-L.step:
FILE_NAME( 'e:/temp/worker_309/temp/exporttempdir_5740_157_aCrqb/format_0/T1M-04-F-SV-L.stp', '2022-05-09T17:57:29', ( 'License CC BY-ND 4.0' ), ( 'CADENAS' ), ' ', 'PARTsolutions', ' ' );
